grahamthetvi/Switch2GO_AAC_Companion/(commit log)

2026-10-12 Implement initial project structure and setup
    [edge_clip.scad, electronics_case.scad, led_hood.scad]
2026-10-12 Update build guide and firmware configuration; added upload speed to platformio.ini, clarified relay behavior in main.cpp, and corrected layout comments for LED positions.
    [main.cpp]
2026-10-12 Remove outdated build guide and related files; update README for clarity on prints and firmware flashing instructions. Adjust comments in CAD files and platformio.ini for consistency with README upda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
    [edge_clip.scad, electronics_case.scad, led_hood.scad]
2026-10-12 Update README with hardware references and clarify build instructions; enhance CAD file comments for the Switch2GO AAC Companion case design.
    [electronics_case.scad]
2026-10-12 Remove temporary lock file and update README to clarify USB-C breakout connections and resistor configurations; enhance wiring diagrams for better understanding.
2026-10-14 feat: add stage 8 iOS connection and short-press simulator firmware
    [main.cpp, stage7_keyboard.cpp, stage8_ios_sim.cpp]
